Local-Legend/Rocket-Avionics/README.md

# Rocket-Avionics
Estes Rocket Avionics/Telemetry System
