Local-Legend/Rocket-Avionics/3D Prints/infill.SLDPRT

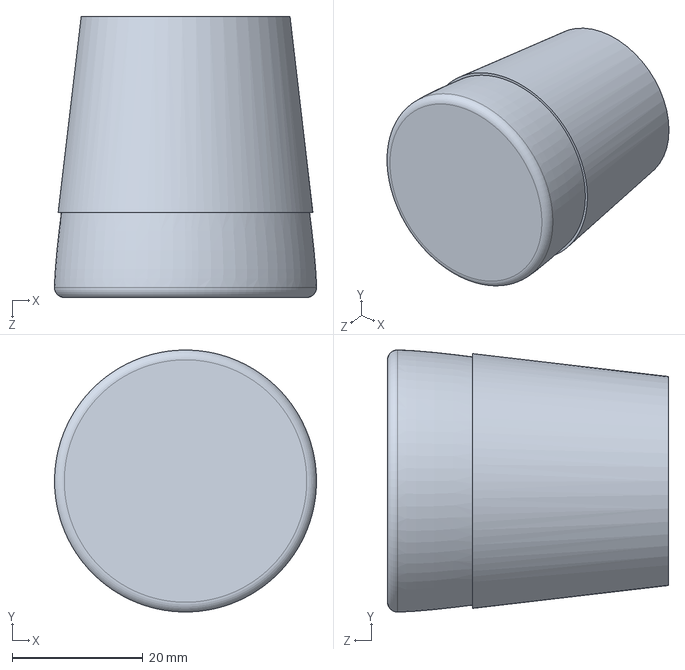
[picture p1: CAD file, 2026-10-27]
3D Prints/infill.SLDPRT
40.1 x 40.1 x 43.0 mm
