Local-Legend/Rocket-Avionics/3D Prints/Telemetry Base.SLDPRT

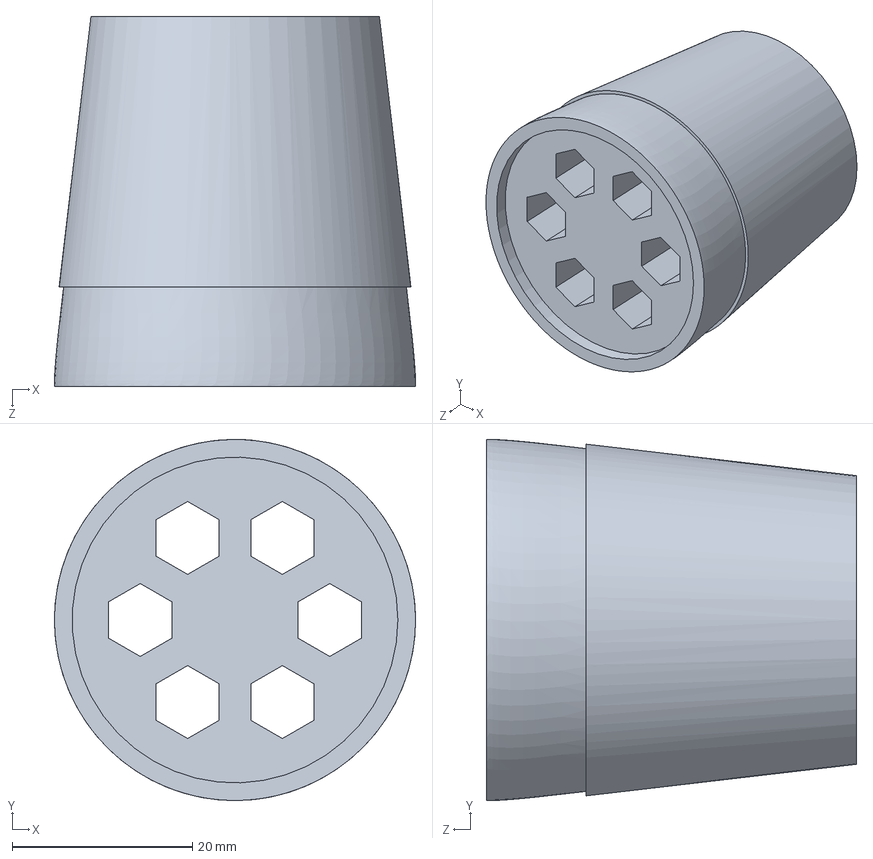
[picture p2: CAD file, 2026-10-27]
3D Prints/Telemetry Base.SLDPRT
40.0 x 40.0 x 41.0 mm
