Local-Legend/Rocket-Avionics/3D Prints/Telemetry.SLDPRT

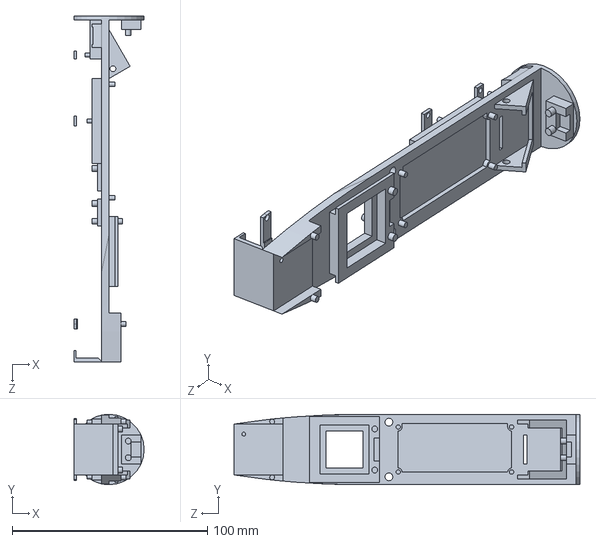
[picture p3: CAD file, 2026-10-27]
3D Prints/Telemetry.SLDPRT
36.0 x 36.0 x 177.0 mm
