Local-Legend/Rocket-Avionics/3D Prints/GPS.SLDPRT

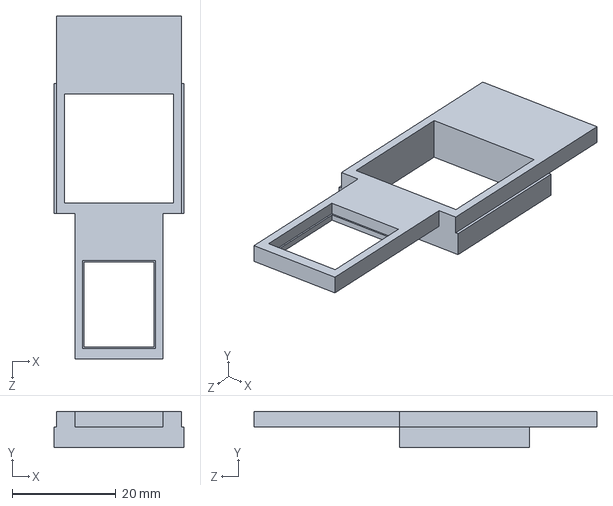
[picture p4: CAD file, 2026-10-27]
3D Prints/GPS.SLDPRT
25.0 x 7.00 x 66.0 mm
