Local-Legend/Rocket-Avionics/3D Prints/Ground Station v2.SLDPRT

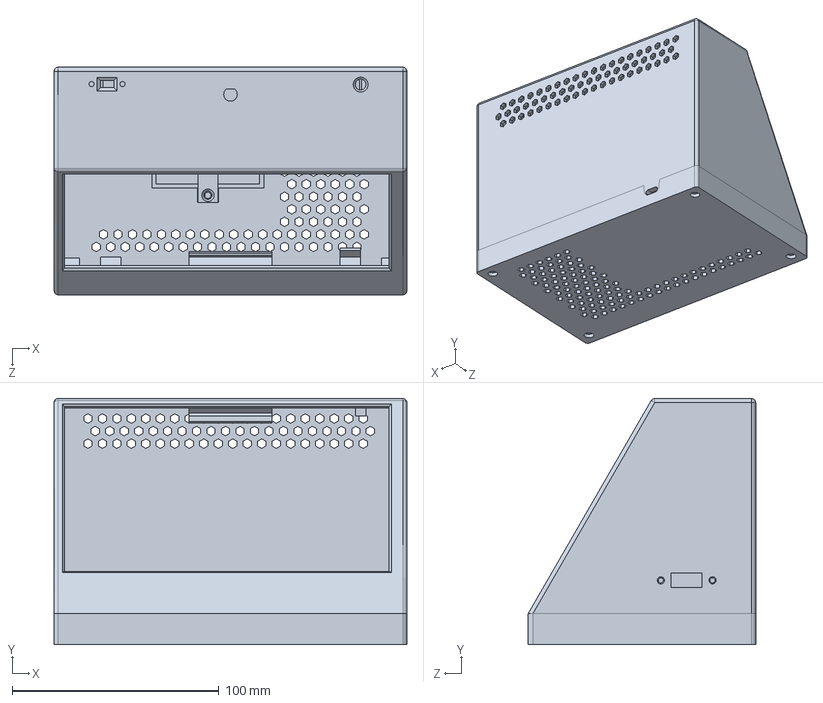
[picture p5: CAD file, 2026-10-27]
3D Prints/Ground Station v2.SLDPRT
170.6 x 118.9 x 110.0 mm
