Local-Legend/Rocket-Avionics/3D Prints/bolt.SLDPRT

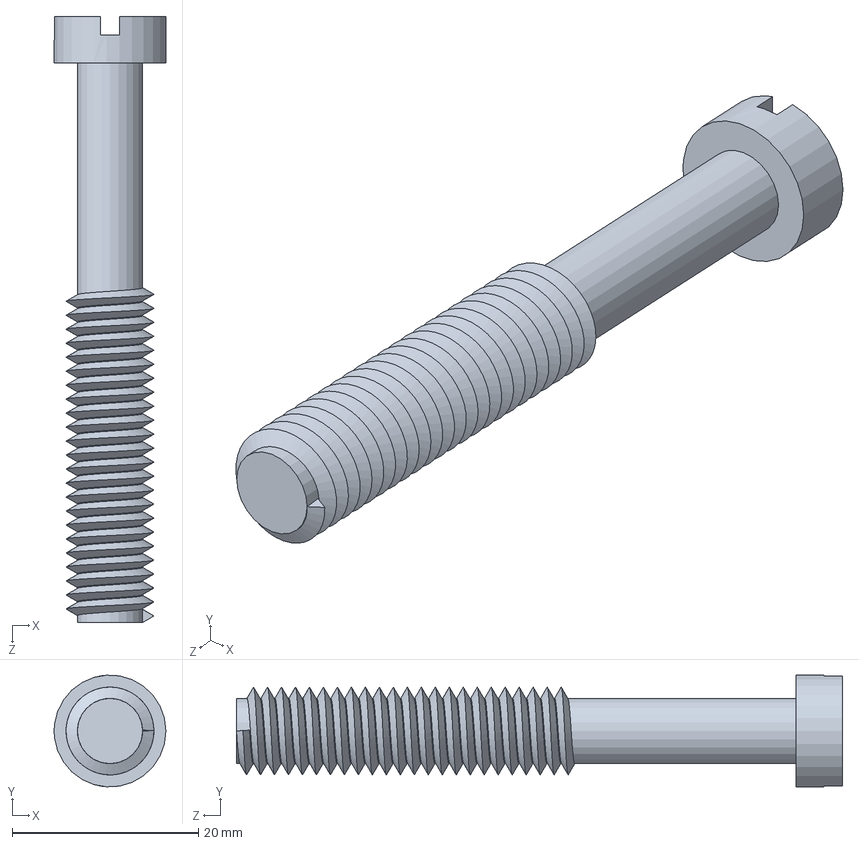
[picture p6: CAD file, 2026-10-27]
3D Prints/bolt.SLDPRT
12.0 x 12.0 x 65.0 mm
