Local-Legend/Rocket-Avionics/.agents/tasks/rx-header-layout-verification.png

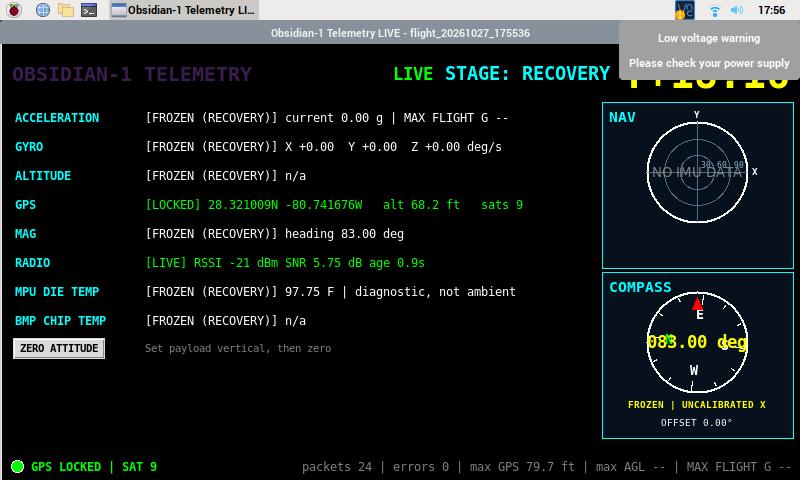
.agents/tasks/rx-header-layout-verification.png
