Local-Legend/Rocket-Avionics/AccelTest.py

#!/usr/bin/env python
"""Released under the MIT License
Copyright 2015, 2016 MrTijn/Tijndagamer
"""

from mpu6050 import mpu6050
from time import sleep

sensor = mpu6050(0x68)
x = 1
while True:
    accel_data = sensor.get_accel_data()
    gyro_data = sensor.get_gyro_data()
    temp = sensor.get_temp()

    print("Accelerometer data")
    print("x: " + str(accel_data['x']))
    print("y: " + str(accel_data['y']))
    print("z: " + str(accel_data['z']))

    print("Gyroscope data")
    print("x: " + str(gyro_data['x']))
    print("y: " + str(gyro_data['y']))
    print("z: " + str(gyro_data['z']))

    print("Temp: " + str(temp) + " C")
    print("---------------------------" + str(x))
    x=x+1      
    sleep(0.5)
